namatamago-900/quick-shifter-with-claude-code/README.md

# quick-shifter-with-claude-code
Ducati 900ss (1995年式) にArduino nanoを使用したクイックシフターを実装するプロジェクトである。コード生成はClaude codeがすべて実装する。
