namatamago-900/quick-shifter-with-claude-code/docs/implementation/05-hardware-scope-tuning.md

# 05. ハードウェア要件・スコープ外・チューニング

ピンアサイン正本（`docs/arduino/pin_assign.md`）への差分、本実装スコープ外の機能、実装完了後のチューニング手順。

---

## 1. ハードウェア要件（pin_assign.md への差分）

ピン正本は `docs/arduino/pin_assign.md`。本実装では**2ピン追加と1件の誤記訂正**を pin_assign.md 側で行う必要がある。

### 1.1 追加ピン

| ピン | 役割 | 入出力 | 接続先 | 備考 |
|---|---|---|---|---|
| **D4** | ニュートラルスイッチ | INPUT_PULLUP | 既存ニュートラルインジケータ配線（`wiring.md` (14)） | アクティブLOW、並列分岐 |
| **D7** | 状態LED | OUTPUT | 外部LED + 330Ω 抵抗 + GND | アクティブHIGH、D13 内蔵LEDにミラー可 |

### 1.2 誤記訂正
- `pin_assign.md` の D3 備考欄「外部割り込み(INT0)」→ 正しくは **INT1**（Nano の INT0 は D2、INT1 は D3）

### 1.3 シフトセンサーの単方向性確認

ヤマハ 13S-82470-00（および同等品）の前提として、**上方向（シフトアップ方向）プッシュ時のみ ON** となる単方向動作が必要。もし双方向（シフトアップ/ダウン両方で ON）であれば、シフトダウン時に QS が誤発動し、駆動系ドッグに過大荷重がかかる重大事故になる。

着手前に：
- メーカー仕様書または現物試験で単方向性を確認
- 結果を `docs/domain/sensors.md` §1 に明記
- 万一双方向品しか入手できない場合は **機構的に上方向のみ作動する取り付け** を別途検討

### 1.4 ニュートラルスイッチ配線

既存メインハーネスのニュートラルインジケータ信号線を分岐して D4 に接続。元のニュートラルランプ回路には干渉しない（並列読み取りのみ）。「Nのとき GND 接続 = LOW」、`INPUT_PULLUP` で読み取り。

### 1.5 本実装着手前のドキュメント追対応チェックリスト

| # | 対象ファイル | 内容 |
|---|---|---|
| 1 | `docs/arduino/pin_assign.md` | D4（N）と D7（LED）の追加、D3 の INT0→INT1 誤記訂正、全入力ピンの極性・`INPUT_PULLUP` 要否欄を追加 |
| 2 | `docs/domain/sensors.md` | シフトセンサーの単方向性（上方向プッシュ時のみ ON）を明記 |
| 3 | `docs/domain/ignition.md` | 本実装が片側ピックアップのみをタップする旨を補足 |

---

## 2. スコープ外・将来拡張

### 2.1 本実装スコープ外
- シフトダウン補助（オートブリッパー）：スロットル制御が必要、本車に機構なし
- 車速連動カット時間補正：車速センサーなし
- 自動ギア学習（rpm低下率からの逆推定）：本実装は N基点カウントで決定的に運用

### 2.2 将来拡張余地
- **ギア推定ずれの自動検知**：[01-control-strategy.md](./01-control-strategy.md) §ギア推定ずれの観測 のログを走行中に自動判定して ERROR 表示
- **クラッチセンサー断線検知**：常時微弱電流の電圧モニタ回路を追加
- **2チャンネル独立カット**：水平・垂直コイルを別ピン制御、段差カットでアフターファイア低減
- **キャリブレーションモード**：シフトSW長押し起動で `REVS_REQUIRED_X10[]` を EEPROM 書換
- **rpm 信号源の冗長化**：タコメーター信号線（IDS → REV COUNTER, `wiring.md` (5)、整形済みで安定）併用してフェイルオーバー
- **OLED表示**：rpm／現在ギア／直近カット時間のリアルタイム表示

---

## 3. チューニング手順（実装完了後）

実装完了後に実走で `REVS_REQUIRED_X10[]` を追い込む。手順詳細は実装完了時点で別途まとめる予定。要点のみ列挙：

1. **ベンチテスト**：エンジン停止、各SWを手動操作し DEBUG_MODE で状態遷移を確認。擬似rpmパルス入力でカット出力を実測
2. **停車エンジンON**：LED が LOCKED→IDLE、クラッチ抑制、rpm下限抑制を確認
3. **低速実走（1→2のみ）**：`MAX_CUT_MS` を一時的に 80 に絞る。突き上げ感／吹け上がり過剰／アフターファイア兆候（マフラー内パンッ音、白煙）を観察しつつ `REVS_REQUIRED_X10[0]` を調整
4. **全ギア追い込み**：4500rpm 帯と 7000rpm 帯で各シフト遷移を試し、ログの `ratio_x1000` を `gear.md` のギア比ステップと照合
5. **本番ビルド**：`MAX_CUT_MS` を 120 に戻し、`DEBUG_MODE` をコメントアウト
