namatamago-900/quick-shifter-with-claude-code/docs/実装方針検討.md

# 実装方針検討 — Ducati 900SS クイックシフター（Arduino Nano）

本ドキュメントは `docs/implementation/README.md` に移行した。
