namatamago-900/quick-shifter-with-claude-code/docs/implementation/01-control-strategy.md

# 01. 制御方針

カット時間決定式・ギア状態管理・クラッチ抑制・クールダウンなど **「いつ・どれだけ点火を切るか」** を司る方針。実装は `gear_logic` 層が担う（[02-architecture.md](./02-architecture.md) §層間の依存規則 参照）。

---

## 1. カット時間の決定式

カット時間は **rpm とギアの両方から動的に算出** する。AVR の浮動小数演算を避けるため**整数演算で完結**させる（係数を10倍に整数化）。

```cpp
// REVS_REQUIRED_X10[idx] : revs_required を ×10 した整数値
// インデックスは gear - 1（gear ∈ [1,5] のみ計算経路に到達する）
if (current_rpm == 0) return MIN_CUT_MS;   // 0除算ガード（AVR の uint32/0 は未定義動作）
uint32_t cut_time_ms = (uint32_t)REVS_REQUIRED_X10[gear - 1] * 6000UL / current_rpm;
cut_time_ms = constrain(cut_time_ms, MIN_CUT_MS, MAX_CUT_MS);
```

物理的根拠：ドッグが抜けるのに必要なのは「時間」ではなく**駆動軸の空転量**。クランク回転数で抽象化することで、高rpmでは自動的に短く、低rpmでは長く、各ギアの噛み合い特性に応じた値が得られる。

`gear` 範囲外（N および 6速）の阻止は [02-architecture.md](./02-architecture.md) §抑制条件 に一元化されている。本式に到達した時点で `gear ∈ [1,5]` が保証される。

## 2. `REVS_REQUIRED_X10` 初期値

`docs/domain/gear.md` のギア比ステップに比例配分。

| インデックス | シフト遷移 | ギア比ステップ | `REVS_REQUIRED_X10` | rpm=5000 検算 | rpm=7000 検算 |
|---|---|---|---|---|---|
| `[0]` | 1→2 | 71.5% (-28.5%) | **80** | 96 ms | 69 ms |
| `[1]` | 2→3 | 76.5% (-23.5%) | **70** | 84 ms | 60 ms |
| `[2]` | 3→4 | 80.8% (-19.2%) | **60** | 72 ms | 51 ms |
| `[3]` | 4→5 | 87.8% (-12.2%) | **50** | 60 ms | 43 ms |
| `[4]` | 5→6 | 89.4% (-10.6%) | **45** | 54 ms | 40 ms（下限クランプ） |

これらは机上計算による初期値。実走チューニングで補正する前提。

## 3. 絶対クランプ

| 定数 | 値 | 根拠 |
|---|---|---|
| `MIN_CUT_MS` | **40 ms** | `ignition.md` 推奨範囲下端。ドッグ移動に必要な機械的最小時間 |
| `MAX_CUT_MS` | **120 ms** | `ignition.md` 推奨上限。キャブ車のアフターファイア・エンスト回避 |

異常入力（rpm極小、配列インデックス異常）で計算が破綻しても本クランプで安全側に倒れる。**初期セットアップ時は `MAX_CUT_MS = 80` まで絞り段階拡張する**（アフターファイア抑制のため）。

## 4. 作動許可rpmレンジ

```cpp
if (rpm < QS_RPM_MIN || rpm > QS_RPM_MAX) { /* QS抑制 */ }
```

| 定数 | 値 | 根拠 |
|---|---|---|
| `QS_RPM_MIN` | **3000 rpm** | `common.md` §4 推奨。キャブ車失火・エンスト防止 |
| `QS_RPM_MAX` | **8500 rpm** | `ignition.md` 最大出力発生回転数。レブリミット(9000)直前のオーバーシュート対策 |

## 5. ギア状態管理

### 5.1 ギアカウンタの更新ルール

ギアポジションセンサーがないため、ニュートラルスイッチと QS シフトイベントを組み合わせて推定する。**Nの押下/離脱エッジを明示的に扱う**ことが重要（カウンタが進む契機を確保するため）。

```cpp
// 毎ループ実行（neutralIsPressed はデバウンス済み）
bool nNow = neutralIsPressed();
if (nNow && !nPrev) {
  currentGear = 0;            // Nに入ったエッジ
} else if (!nNow && nPrev) {
  currentGear = 1;            // Nから抜けたエッジ = 手動で1速にシフトダウンした
}
nPrev = nNow;

// QS シフトイベント完了時（CUTTING → COOLDOWN 遷移時、shifter から notifyShiftCompleted() 経由で通知される）
if (currentGear >= 1 && currentGear < 6) {
  currentGear++;              // 1→2, 2→3, ..., 5→6
}
```

この方式の前提と限界：
- **前提**：N→1 はクラッチ操作による手動シフト（シフトセンサーは上方向のみ反応のため、ペダルを踏み下げるN→1動作では発火しない）。N離脱エッジで「1速に入った」と推定する
- **限界**：1→N→2 のような飛びシフトでは、N離脱エッジで `currentGear=1` に固定セットされるため、**実ギアより1段少ない値で認識される**。これは次に N を経由するまで継続する（実走チューニング時にログで観測）
- **回復**：N を一度経由すれば再同期する

`currentGear` の宣言：`uint8_t currentGear`（取り得る値 `0..6`、0=N、1..6=各ギア）。`gear - 1` を引く前に `currentGear >= 1` であることは [02-architecture.md](./02-architecture.md) §抑制条件 で保証される（`uint8_t(0) - 1 = 0xFF` の罠を回避）。

### 5.2 起動時のロックアウト

Arduino起動時、N未観測の状態では現在ギアが不明。誤推定によるアフターファイア・失火を避けるため、**N を一度観測するまで QS を完全にロックアウト** する（LOCKED 状態。詳細は [02-architecture.md](./02-architecture.md) §ステートマシン）。

| 起動シナリオ | 振る舞い |
|---|---|
| N で起動（通常起動） | LOCKED→IDLE に即遷移、通常動作 |
| 走行中Arduinoのみ再起動（停車で1速＋クラッチ等） | LOCKED 継続、ライダーが N に戻すと解除 |

ロックアウト中は状態LEDがゆっくり点滅（[04-safety.md](./04-safety.md) §LED表示 参照）。

### 5.3 ギア推定ずれの観測（自動補正はスコープ外）

自動補正は本実装スコープ外。チューニングと事後解析のため、**シフト前後の rpm を DEBUG ログに必ず残す**（[03-sensors-io.md](./03-sensors-io.md) §ログ出力項目）。`ratio = rpm_post / rpm_pre` を `gear.md` のギア比ステップと照合して、ずれを目視で検出する。

## 6. クラッチセンサーの役割

クラッチセンサー（DRC F5945 油圧スイッチ）の役割は **QSの抑制（インヒビット）** に限定する。ライダーがクラッチを握っている＝意図的な手動シフト中、と解釈する。

```cpp
if (clutchPressed) { /* QS抑制：state は IDLE 維持 */ }
```

## 7. クールダウン

カット完了後、次のシフト検知を受け付けるまで **300 ms** 待つ。連続誤発動・カット直後のrpm揺り戻し誤検知の防止。人間の物理的な連続シフト最短間隔（脚の戻し時間）と整合する。
