namatamago-900/quick-shifter-with-claude-code/(commit log)

2026-05-18 ドキュメント作成 (#1)
    * created docs
    * Update README.md
    * Update pin_assign.md
    * Create CLAUDE.md
    * fixed wiring.md
    * Update wiring.md
    * fixed pin mode
    * Update wiring.md
    * fixed pin assign
    * added github workflow
    * added present wiring diagram
    * added wiring png
    * Update 実装方針検討.md
    * Update pin_assign.md
    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
2026-05-19 実装方針検討 (#5)
    * Create 実装方針検討.md
    * Create レビュー指摘.md
    * review feedback
    * Update レビュー指摘.md
    * review feedback
    * Update レビュー指摘.md
    * review feedback
    * Update レビュー指摘.md
    * review feedback
    * Delete レビュー指摘.md
    * break down implementation plan
    * Create 実装方針検討_obsolute.md
    * added outline
    * Update 02-architecture.md
2026-05-20 fix: ドキュメント分割レビュー指摘の対応 (#12)
    * fix: 誤リンク訂正・config.h コメントの参照先を明示化
    - README.md: チェックリスト注記の「§5.5」を正しい「§1.5」に訂正（指摘4）
    - 02-architecture.md: config.h コメント内の暗黙参照を具体的なファイル相対パスに復元
    - 「出力はアクティブHIGH」に (docs/implementation/04-safety.md §2) を追加
    - D5 コメントの「単方向性要確認」に (05-hardware-scope-tuning.md §1.3) を追加（指摘1）
    * refactor: チェックリスト表の一元化・実装方針検討.md をリダイレ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
2026-05-22 実装追加 (#14)
    * feat: src/config.h を追加 (#6)
    02-architecture.md §config.h 全体像 を写経。
    ピン定義・rpm閾値・カット時間・タイミング・デバッグフラグを一元管理する。
    * feat: sensors層を実装（RPM計測・スイッチデバウンス） (#7)
    * feat: sensors層を実装（RPM計測・スイッチデバウンス）
    03-sensors-io.md §RPM計測 / §シフト・補助スイッチ に基づき
    src/sensors.h と src/sensors.cpp を追加。
    - ISR による RPM パルス計測（直近4パルス移動平均）
    - 信号断検出（RPM_TIMEOUT_MS、isRpmSignalAlive()）
    - シフト/ク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
2026-05-22 実装完了に合わせて CLAUDE.md を更新 (#15)
    * docs: 実装完了に合わせて CLAUDE.md を更新
    アーキテクチャ・制御フロー・ピンアサイン・ビルド手順を追記。
    「実装はまだ未定」という記述を実際の実装内容に合わせて刷新した。
    * docs: 開発環境を Arduino Community Edition に修正
    VS Code + Arduino Community Edition 拡張を使用していることを明記し、
    旧来の vsciot-engineering 拡張 ID を修正した。
    ---------
